Atakus01/mn-front-end-drawers/1_H/1H_Front_End/1H_Front_End_Assembly/H_Box_Assem.SLDASM

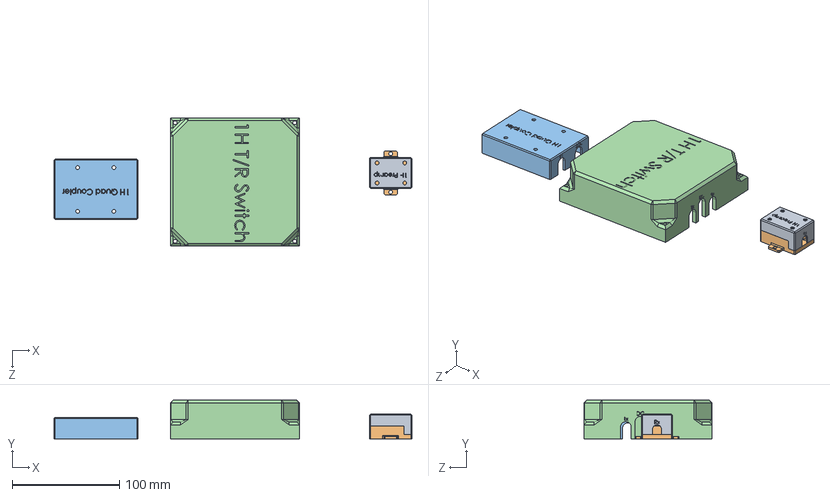
[picture p3: CAD file, 2026-11-05]
1_H/1H_Front_End/1H_Front_End_Assembly/H_Box_Assem.SLDASM
333.1 x 36.0 x 119.2 mm
H_TR_Switch_Case
H_Coupler
PreAmp_Bottom
PreAmp_Case
