Atakus01/mn-front-end-drawers/23_Na/23Na_Front_End/23Na_Front_End_Assembly/Na_Box_Assem.SLDASM

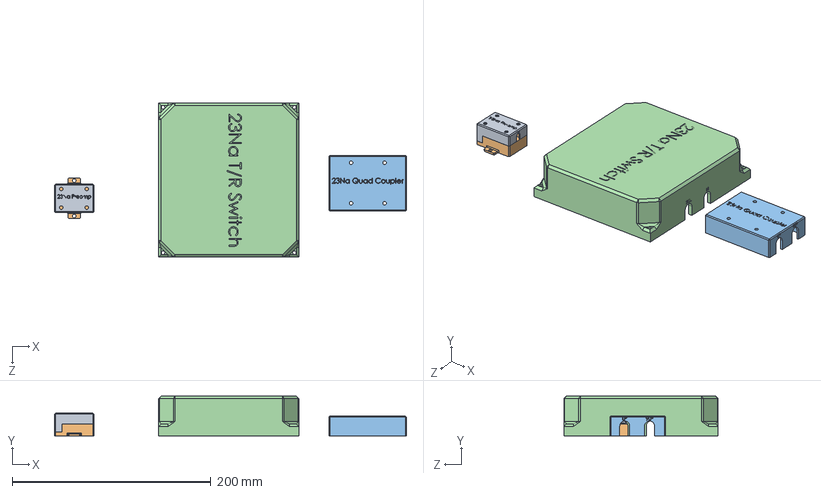
[picture p4: CAD file, 2026-11-05]
23_Na/23Na_Front_End/23Na_Front_End_Assembly/Na_Box_Assem.SLDASM
354.1 x 40.1 x 155.2 mm
Na_TR_Switch_Case_Improved
Na_Coupler
PreAmp_Bottom
Na_PreAmp_Case
