Atakus01/mn-front-end-drawers/23_Na/23Na_Preamp_Shield/Na_PreAmp_Assem.SLDASM

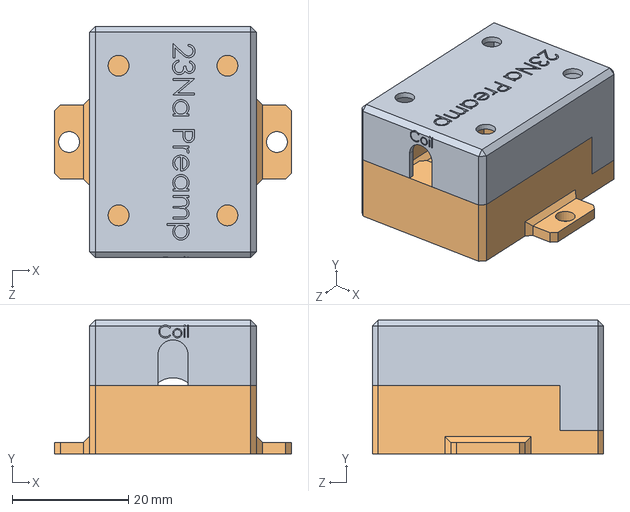
[picture p5: CAD file, 2026-11-05]
23_Na/23Na_Preamp_Shield/Na_PreAmp_Assem.SLDASM
40.7 x 23.0 x 39.7 mm
PreAmp_Bottom
Na_PreAmp_Case
