Atakus01/mn-front-end-drawers/31_P/31P_Front_End/31P_Front_End_Assembly/P_Box_Assem.SLDASM

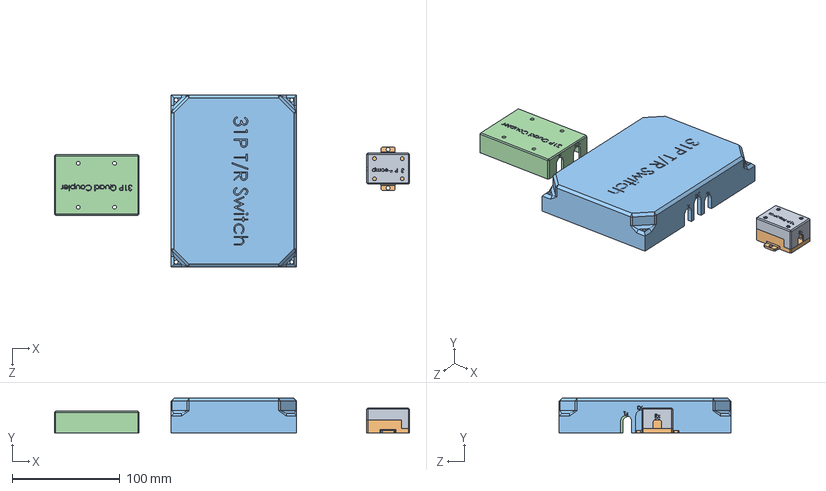
[picture p6: CAD file, 2026-11-05]
31_P/31P_Front_End/31P_Front_End_Assembly/P_Box_Assem.SLDASM
329.1 x 32.0 x 159.2 mm
P_Coupler
P_TR_Switch_Case
PreAmp_Bottom
P_PreAmp_Case
