Atakus01/mn-front-end-drawers/Common Housing/Mian Box Stage Dowel Assem.SLDASM

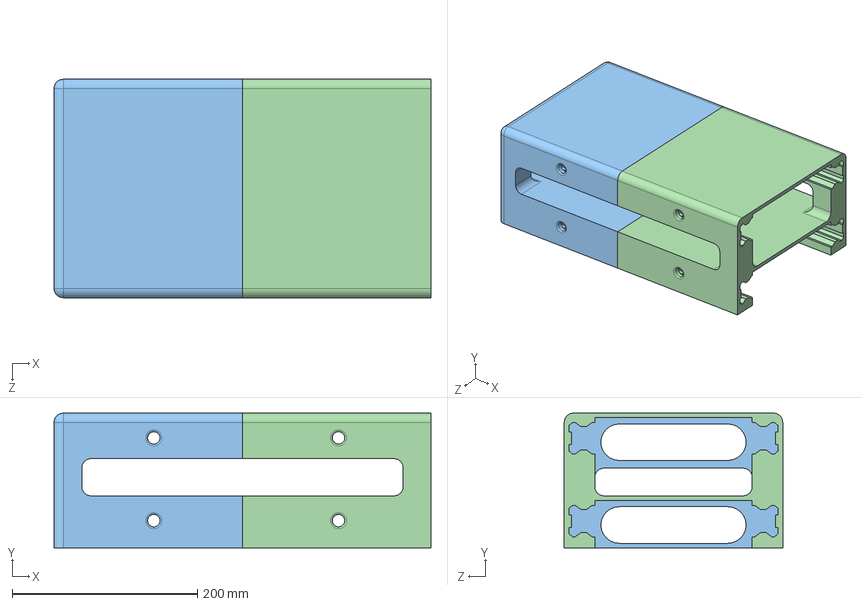
[picture p7: CAD file, 2026-11-05]
Common Housing/Mian Box Stage Dowel Assem.SLDASM
407.1 x 145.6 x 236.0 mm
Main Box Stage Body1
Main Box Stage Body2
Big Dowel x 6
Small Dowel x 2
