Atakus01/mn-front-end-drawers/31_P/31P_Front_End/P Box Assem.SLDASM

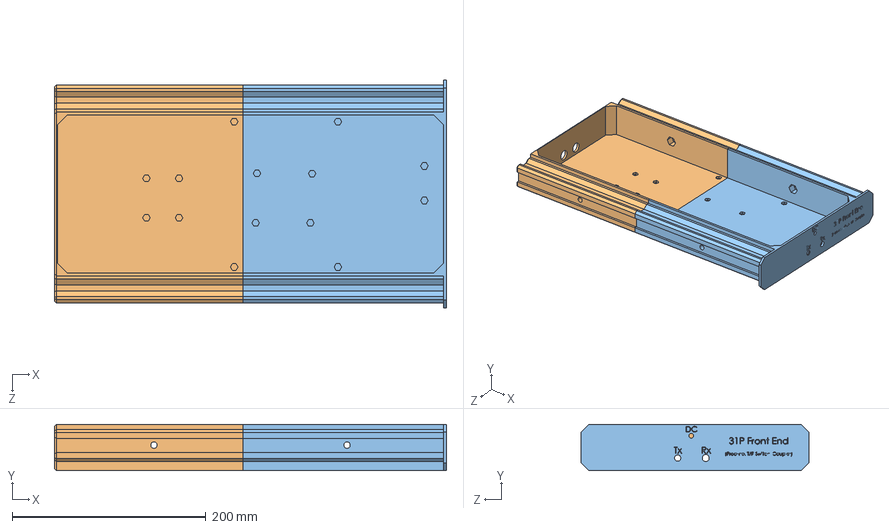
[picture p8: CAD file, 2026-11-05]
31_P/31P_Front_End/P Box Assem.SLDASM
405.1 x 47.8 x 235.2 mm
P Box Body 2
P Box Body 1
Big Dowel x 2
