Atakus01/mn-front-end-drawers/1_H/1H_Front_End/H Box Assem.SLDASM

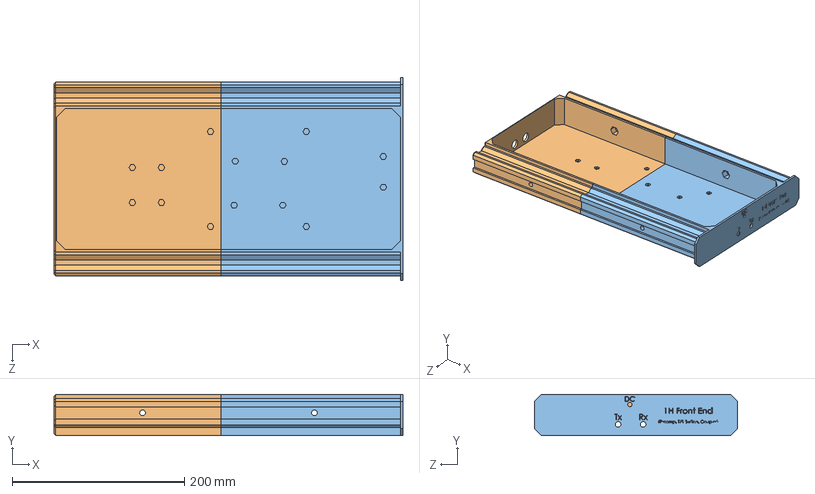
[picture p9: CAD file, 2026-11-05]
1_H/1H_Front_End/H Box Assem.SLDASM
405.1 x 47.8 x 235.6 mm
H Box Body 2
H Box Body 1
Big Dowel x 2
