Atakus01/mn-front-end-drawers/Common Housing/Main Box Stage Body2.SLDPRT

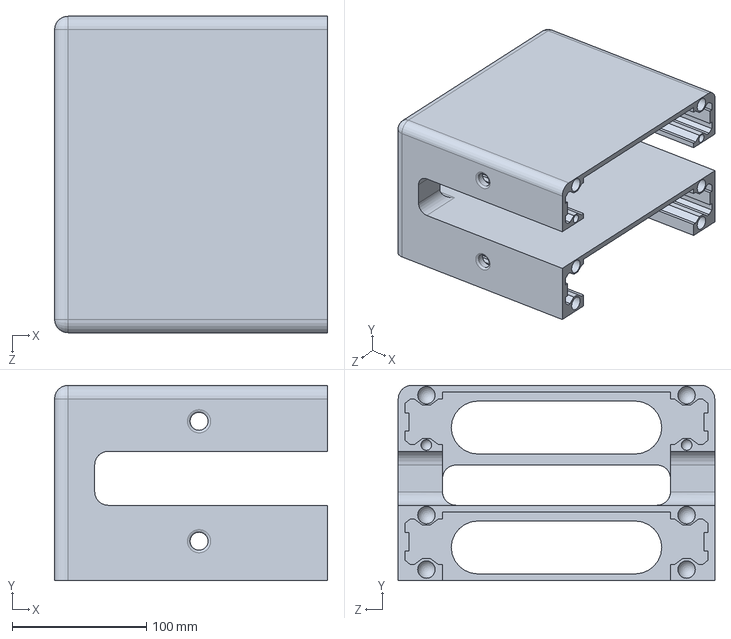
[picture p10: CAD file, 2026-11-05]
Common Housing/Main Box Stage Body2.SLDPRT
203.6 x 145.6 x 236.0 mm
