Atakus01/mn-front-end-drawers/Common Housing/Mian Box Stage Dowel Assem - Main Box Stage Body1-1.3mf

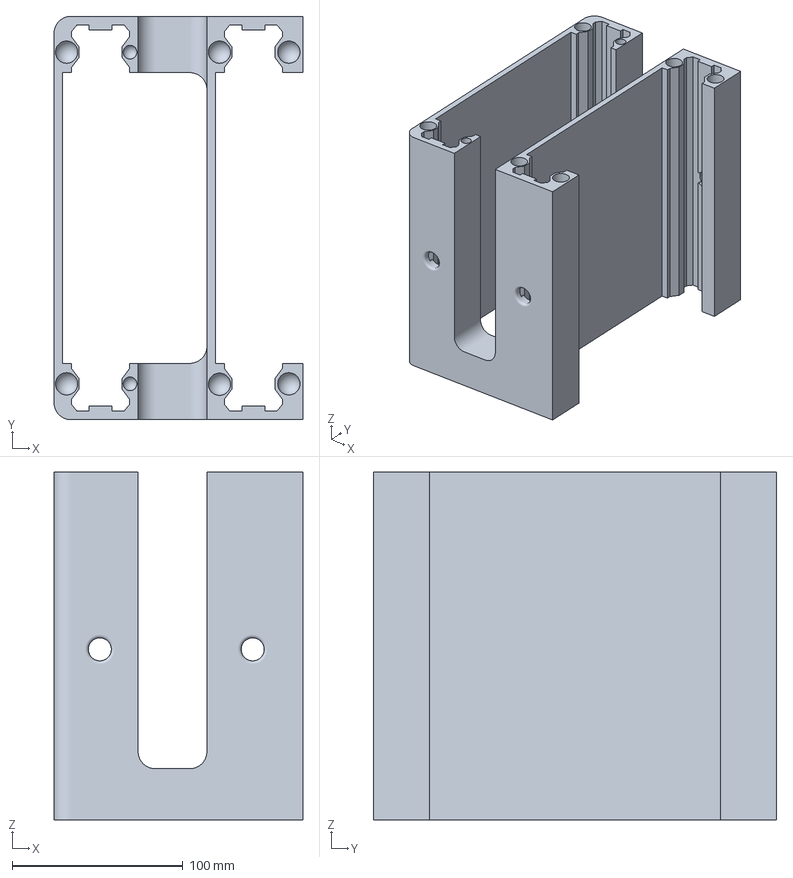
[picture p11: CAD file, 2026-11-05]
Common Housing/Mian Box Stage Dowel Assem - Main Box Stage Body1-1.3mf
145.6 x 236.0 x 203.5 mm
