Atakus01/mn-front-end-drawers/1_H/1H_Front_End/Big Dowel.SLDPRT

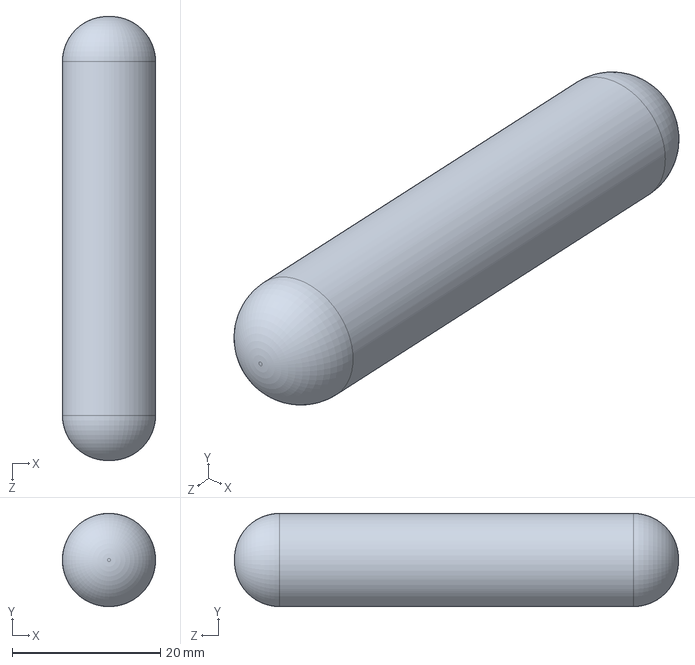
[picture p12: CAD file, 2026-11-05]
1_H/1H_Front_End/Big Dowel.SLDPRT
12.6 x 12.6 x 60.0 mm
