Atakus01/mn-front-end-drawers/1_H/1H_Preamp_Shield/H_PreAmp_Assem - PreAmp_Case-1.STL

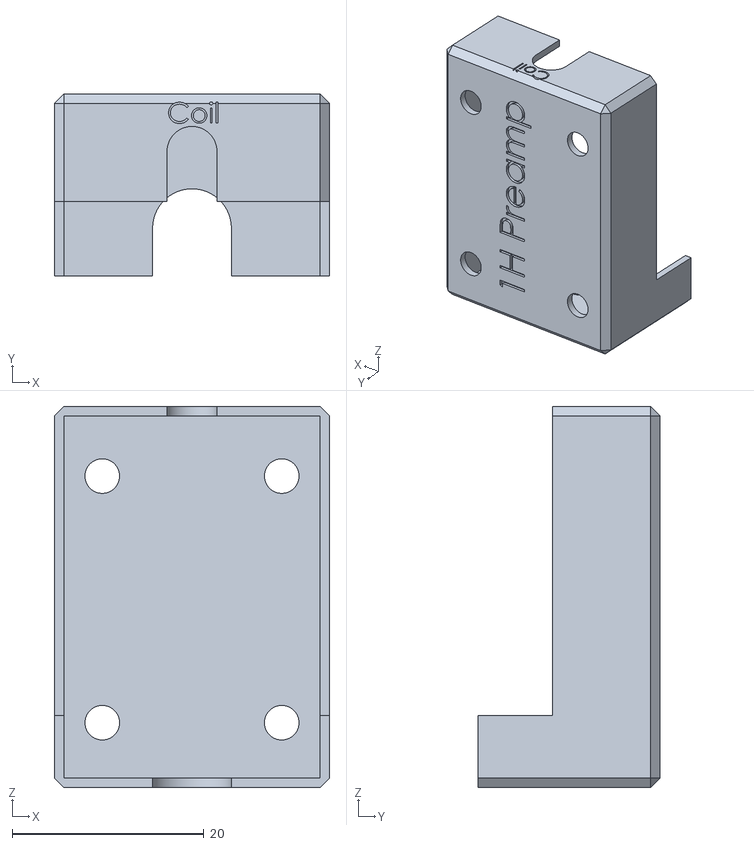
[picture p13: CAD file, 2026-11-05]
1_H/1H_Preamp_Shield/H_PreAmp_Assem - PreAmp_Case-1.STL
28.7 x 19.0 x 39.7
