Atakus01/mn-front-end-drawers/1_H/1H_Quad_Combiner/1H_Quad_Combiner_Shield/H_Coupler.SLDPRT

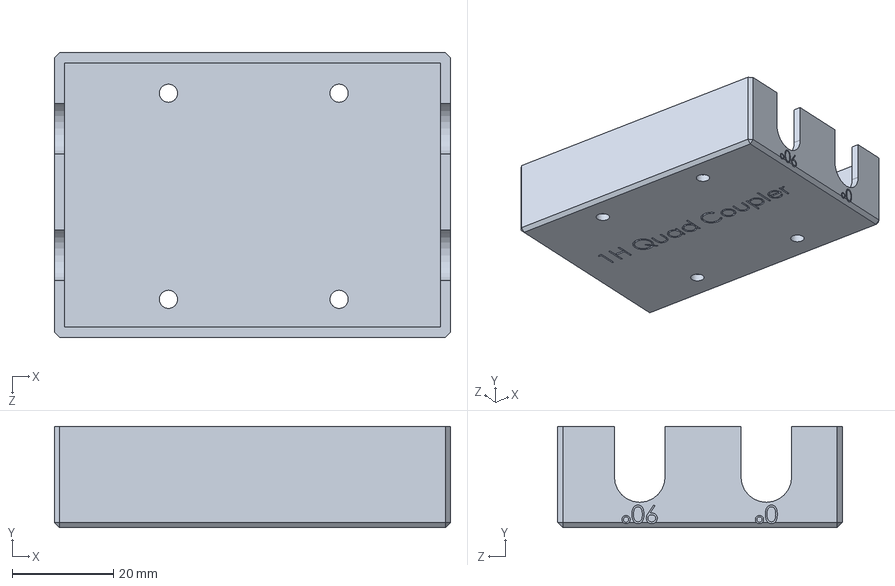
[picture p14: CAD file, 2026-11-05]
1_H/1H_Quad_Combiner/1H_Quad_Combiner_Shield/H_Coupler.SLDPRT
78.2 x 20.0 x 56.2 mm
