Atakus01/mn-front-end-drawers/1_H/1H_TR_Switch/1H_TR_Switch_Shield/H_TR_Switch_Case.SLDPRT

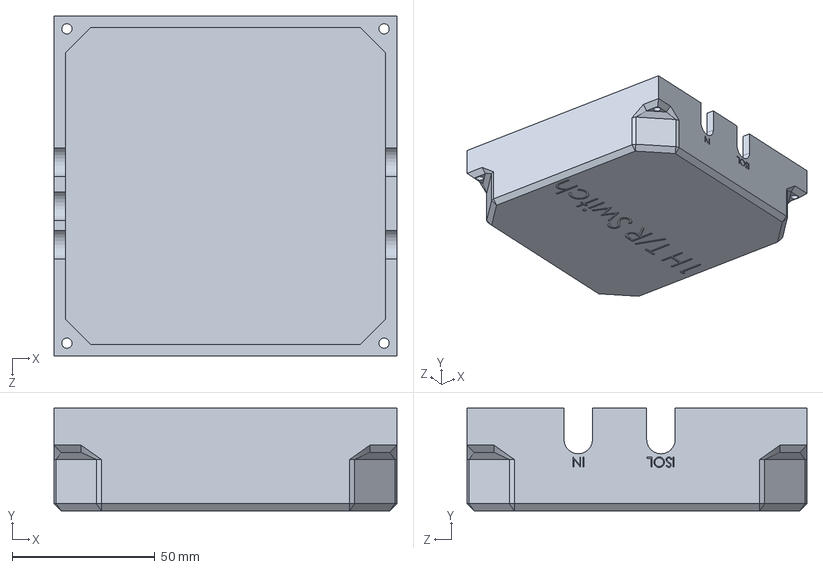
[picture p15: CAD file, 2026-11-05]
1_H/1H_TR_Switch/1H_TR_Switch_Shield/H_TR_Switch_Case.SLDPRT
120.2 x 36.0 x 119.2 mm
