Atakus01/mn-front-end-drawers/23_Na/23Na_TR_Switch/23_Na_TR_Switch_Shield/Na_TR_Switch_Case_Improved.SLDPRT

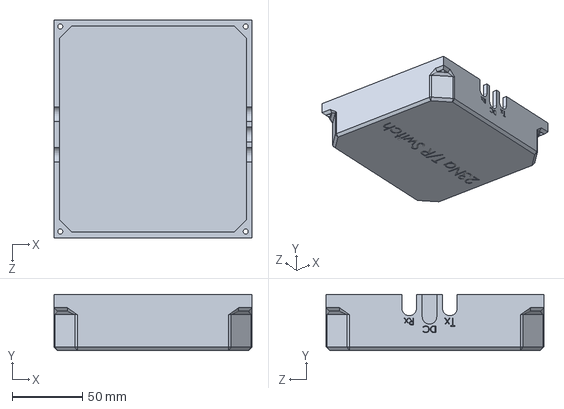
[picture p16: CAD file, 2026-11-05]
23_Na/23Na_TR_Switch/23_Na_TR_Switch_Shield/Na_TR_Switch_Case_Improved.SLDPRT
141.2 x 40.1 x 155.2 mm
