Atakus01/mn-front-end-drawers/31_P/31P_Front_End/P Box Body 1.SLDPRT

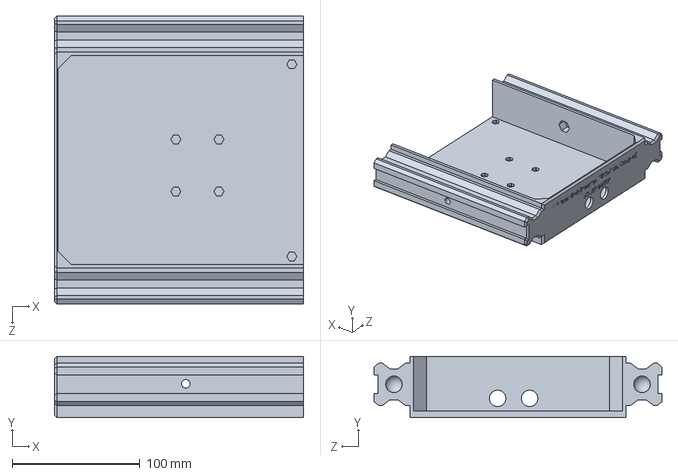
[picture p17: CAD file, 2026-11-05]
31_P/31P_Front_End/P Box Body 1.SLDPRT
194.9 x 47.8 x 225.2 mm
