Atakus01/mn-front-end-drawers/31_P/31P_Preamp_Shield/P_PreAmp_Assem - PreAmp_Bottom-1.STL

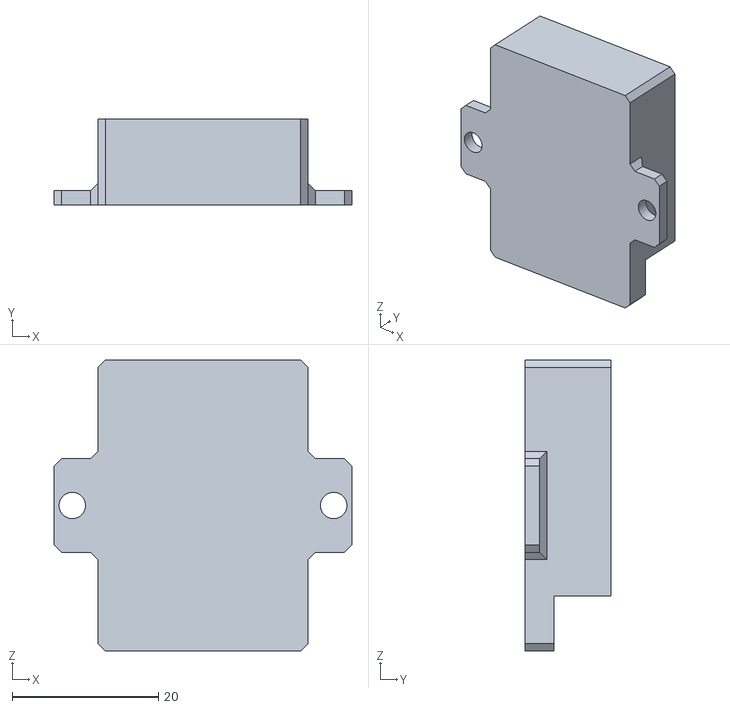
[picture p18: CAD file, 2026-11-05]
31_P/31P_Preamp_Shield/P_PreAmp_Assem - PreAmp_Bottom-1.STL
40.7 x 11.8 x 39.7
