Atakus01/mn-front-end-drawers/31_P/31P_TR_Switch/31P_TR_Switch_Shield/P_TR_Switch_Case.SLDPRT

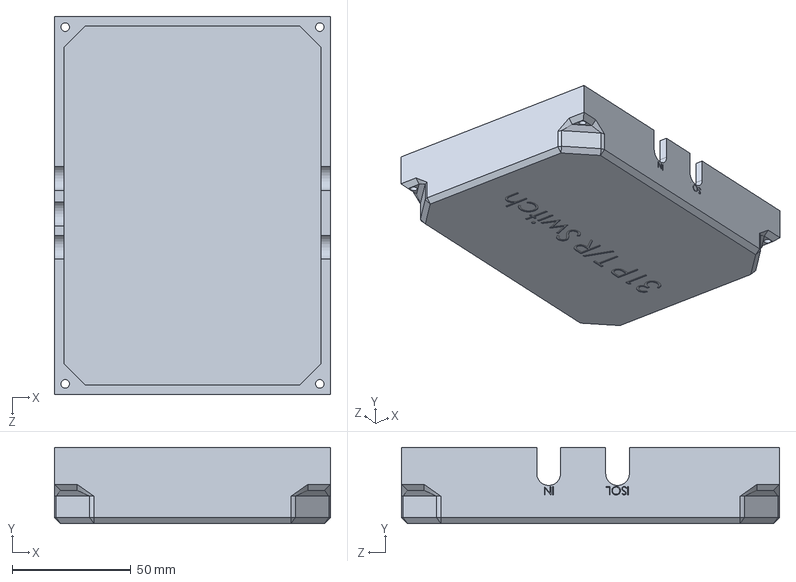
[picture p19: CAD file, 2026-11-05]
31_P/31P_TR_Switch/31P_TR_Switch_Shield/P_TR_Switch_Case.SLDPRT
116.2 x 32.0 x 159.2 mm
