Atakus01/mn-front-end-drawers/Common Housing/Mian Box Stage Dowel Assem - Small Dowel-1.STL

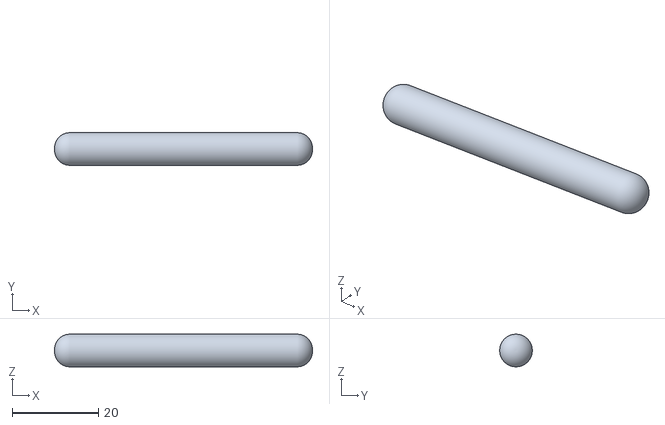
[picture p20: CAD file, 2026-11-05]
Common Housing/Mian Box Stage Dowel Assem - Small Dowel-1.STL
60.0 x 7.60 x 7.60
