Atakus01/mn-front-end-drawers/23_Na/23Na_Preamp_Shield/Na_PreAmp_Case.SLDPRT

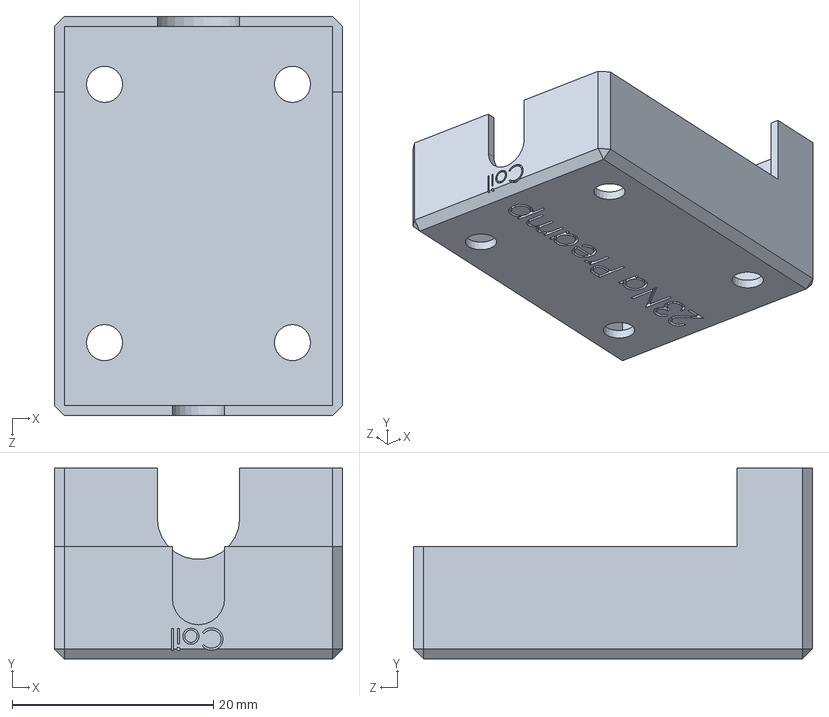
[picture p21: CAD file, 2026-11-05]
23_Na/23Na_Preamp_Shield/Na_PreAmp_Case.SLDPRT
28.7 x 19.0 x 39.7 mm
