Atakus01/mn-front-end-drawers/31_P/31P_Front_End/P Box Assem - P Box Body 2-1.STL

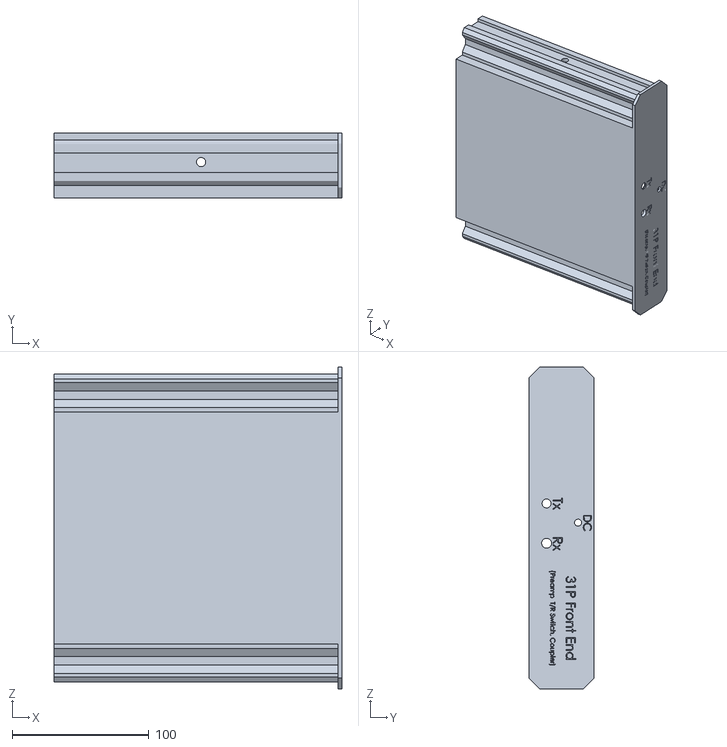
[picture p22: CAD file, 2026-11-05]
31_P/31P_Front_End/P Box Assem - P Box Body 2-1.STL
210.2 x 47.8 x 235.2
