Atakus01/mn-front-end-drawers/23_Na/23Na_Front_End/Na Box Assem - Na Box Body 2-1.STL

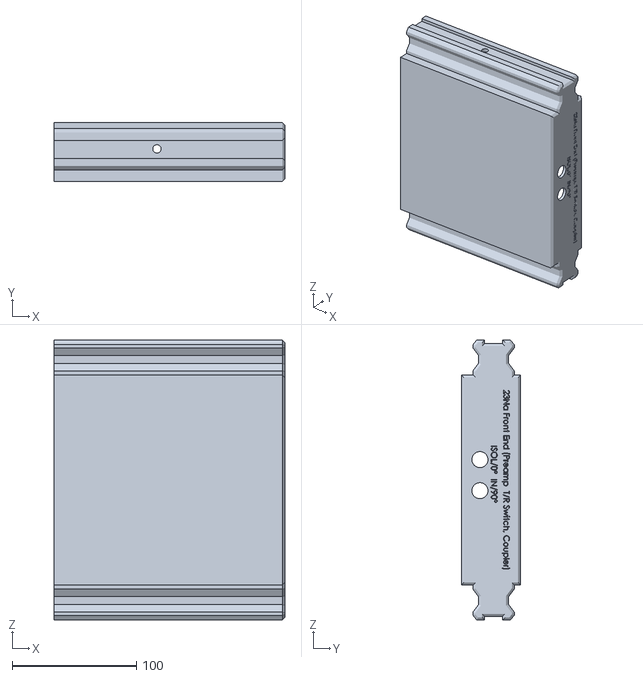
[picture p23: CAD file, 2026-11-05]
23_Na/23Na_Front_End/Na Box Assem - Na Box Body 2-1.STL
185.4 x 47.8 x 225.2
