Atakus01/mn-front-end-drawers/23_Na/23Na_Front_End/Na Box Body 1.SLDPRT

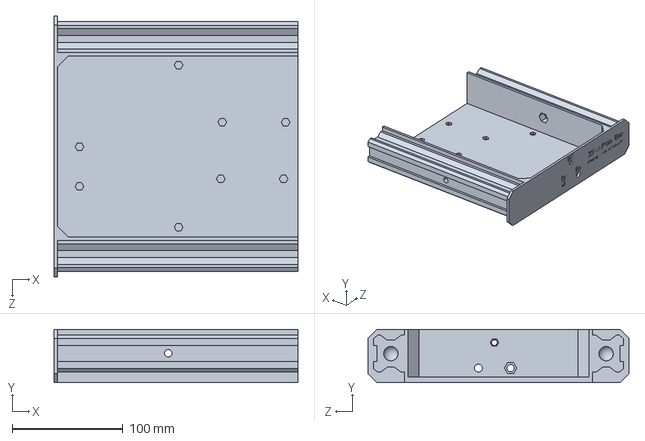
[picture p24: CAD file, 2026-11-05]
23_Na/23Na_Front_End/Na Box Body 1.SLDPRT
219.7 x 47.8 x 235.2 mm
