Atakus01/mn-front-end-drawers/(list of files, cad)

Other CAD files:
31_P/31P_Preamp_Shield/P_PreAmp_Assem.SLDASM
1_H/1H_Preamp_Shield/PreAmp_Assem.SLDASM
23_Na/23Na_Front_End/Na Box Assem.SLDASM
Common Housing/Main Box Stage Body1.SLDPRT
Common Housing/Mian Box Stage Dowel Assem - Main Box Stage Body2-1.STL
23_Na/23Na_Quad_Combiner/23_Na_Quad_Combiner_Shield/Na_Coupler.SLDPRT
31_P/31P_Quad_Combiner/31P_Quad_Combiner_Shield/P_Coupler.SLDPRT
1_H/1H_Front_End/H Box Assem - H Box Body 1-1-1.STL
1_H/1H_Preamp_Shield/H_PreAmp_Assem - PreAmp_Bottom-1.STL
23_Na/23Na_Front_End/Small Dowel.SLDPRT
1_H/1H_Front_End/H Box Assem - H Box Body 2-1-1.STL
1_H/1H_Preamp_Shield/PreAmp_Bottom.SLDPRT
23_Na/23Na_Preamp_Shield/Na_PreAmp_Assem - PreAmp_Bottom-1.STL
31_P/31P_Front_End/P Box Assem - P Box Body 1-1.STL
31_P/31P_Preamp_Shield/P_PreAmp_Case.SLDPRT
1_H/1H_Front_End/H Box Assem - Big Dowel-1-1.STL
23_Na/23Na_Front_End/Na Box Assem - Big Dowel-1.STL
23_Na/23Na_Preamp_Shield/PreAmp_Bottom.SLDPRT
31_P/31P_Preamp_Shield/P_PreAmp_Assem - P_PreAmp_Case-1.STL
Common Housing/Mian Box Stage Dowel Assem - Big Dowel-1.3mf
1_H/1H_Front_End/H Box Body 1.SLDPRT
1_H/1H_Preamp_Shield/PreAmp_Case.SLDPRT
23_Na/23Na_Preamp_Shield/Na_PreAmp_Assem - Na_PreAmp_Case-1.STL
31_P/31P_Front_End/P Box Body 2.SLDPRT
31_P/31P_Preamp_Shield/PreAmp_Bottom.SLDPRT
Common Housing/Small Dowel.SLDPRT
Common Housing/Mian Box Stage Dowel Assem - Big Dowel-5.STL
1_H/1H_Front_End/Small Dowel.SLDPRT
23_Na/23Na_Front_End/Na Box Assem - Na Box Body 1-1.STL
31_P/31P_Front_End/P Box Assem - Big Dowel-2.STL
Common Housing/Mian Box Stage Dowel Assem - Big Dowel-2.STL
1_H/1H_Front_End/H Box Assem - Big Dowel-2-1.STL
23_Na/23Na_Front_End/Na Box Body 2.SLDPRT
31_P/31P_Front_End/Small Dowel.SLDPRT
Common Housing/Mian Box Stage Dowel Assem - Big Dowel-6.STL
1_H/1H_Front_End/H Box Body 2.SLDPRT
23_Na/23Na_Front_End/Na Box Assem - Big Dowel-2.STL
31_P/31P_Front_End/P Box Assem - Big Dowel-1.STL
Common Housing/Mian Box Stage Dowel Assem - Big Dowel-3.STL
Common Housing/Mian Box Stage Dowel Assem - Big Dowel-4.STL
Common Housing/Mian Box Stage Dowel Assem - Small Dowel-2.STL
1_H/1H_Quad_Combiner/1H_Quad_Combiner_Shield/H_Coupler.STL
1_H/1H_TR_Switch/1H_TR_Switch_Shield/H_TR_Switch_Case.STL
23_Na/23Na_Quad_Combiner/23_Na_Quad_Combiner_Shield/Na_Coupler.STL
23_Na/23Na_TR_Switch/23_Na_TR_Switch_Shield/Na_TR_Switch_Case_Improved.STL
31_P/31P_Quad_Combiner/31P_Quad_Combiner_Shield/P_Coupler.STL
31_P/31P_TR_Switch/31P_TR_Switch_Shield/P_TR_Switch_Case.STL
Common Housing/Mian Box Stage Dowel Assem - Big Dowel-1.STL
Common Housing/Mian Box Stage Dowel Assem - Main Box Stage Body1-1.STL
