Atakus01/mn-front-end-drawers/Preamplifier_Mounting_Board/Preamp Board.kicad_sch

## KiCad design Preamplifier_Mounting_Board/Preamp Board.kicad_sch (2026-11-05)

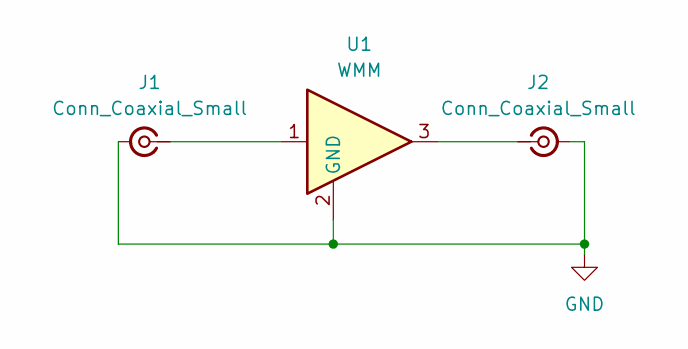
[picture p25: schematic Preamp Board.kicad_sch]

Parts:
J1, J2: Conn_Coaxial_Small; SMA_EdgeMount_Horizontal
U1: WMM

Connections:
GND: J1.2 (Ext), J2.2 (Ext), U1.2 (GND)
unnamed: J1.1 (In), U1.1
unnamed: J2.1 (In), U1.3
